mawrob/Tesla-model-S-front-camera/pcb.jpg

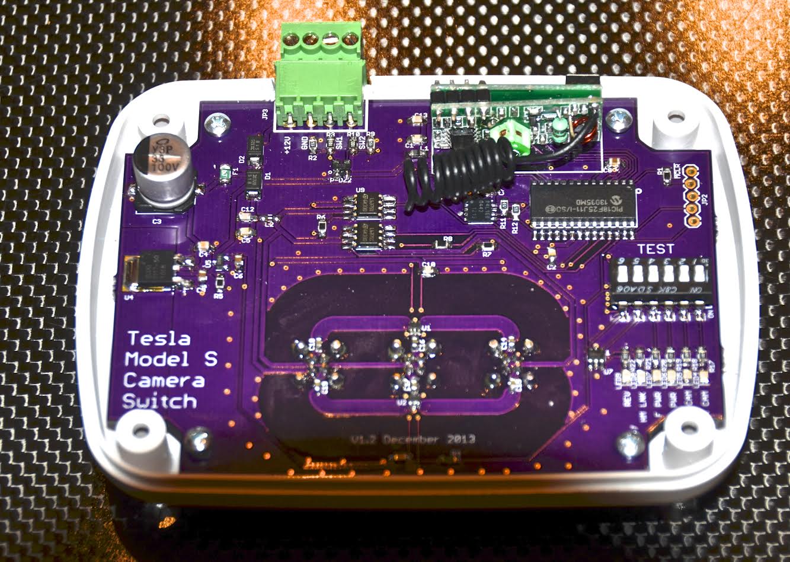
pcb.jpg
