mawrob/Tesla-model-S-front-camera/README.md

# Tesla-model-S-front-camera
Module to enable switching between a newly added front camera and the standard rear camera.

These are the camera switch manufacturing files for a Tesla Model S.

See: http://www.teslarati.com/tesla-model-s-front-camera-touchscreen-kit/
