mawrob/Tesla-model-S-front-camera/RT079 modification.pdf

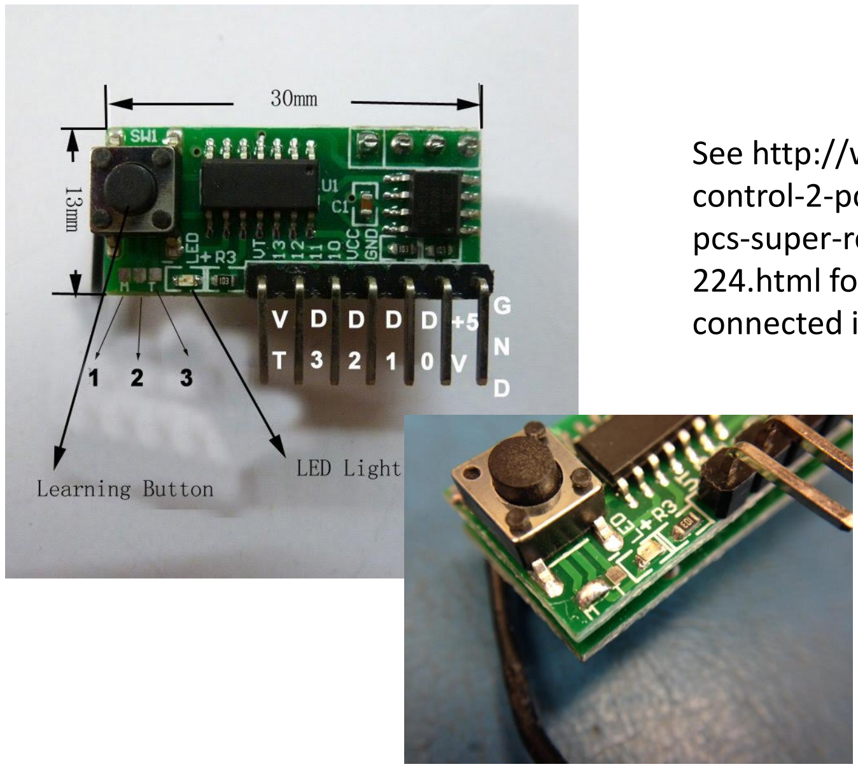
[picture p2: figure]

See http://www.canton-electronics.com/wirelesscontrol-2-pcs-4-way-ev1527-encoder-remotes-1-pcs-super-regenerative-receivers-433mhz-p-224.html for details. Pads 1 and 2 need to be connected in the "momentary" mode.
