mawrob/Tesla-model-S-front-camera/BOM.xlsx

VALUE | DESCRIPTION | MFR | MFPN | VEND | VPN | QTY | EACH | COST | REF | NOTES
33uF | CAP ALUM 33UF 100V 20% SMD | Nichicon | UUX2A330MNL1GS | Digi-Key | 493-6281-1-ND | 1 | 0.33428 | 0.33428 | C3 | Alternative Panasonic EEE-HD1J330P
0.1uF | CAP CER 0.1UF 50V 10% X7R 0805 | AVX CORPORATION (VA) | 08055C104KAT2A | Digi-Key | 478-1395-1-ND | 5 | 0.019 | 0.095 | C10,C7,C5,C2,C1
0.01uF | CAP CER 10000PF 50V 10% X7R 0805 | Kemet | C0805C103K5RACTU | Digi-Key | 399-1158-1-ND | 3 | 0.0154 | 0.0462 | C13,C12,C11
10uF | CAP CER 10UF 10V Y5V 0805 | Yageo | CC0805ZKY5V6BB106 | Digi-Key | 311-1355-1-ND | 3 | 0.0522 | 0.1566 | C9,C8,C6
1uF | CAP CER 1UF 50V 10% X5R 0603 | Taiyo Yuden | UMK107BJ105KA-T | Digi-Key | 587-2400-1-ND | 6 | 0.0523 | 0.3138 | C19,C18,C17,C16,C15,C14
1uF | CAP CER 1UF 50V Y5V 0805 | Samsung Electro-Mechanics America, Inc | CL21B105KBFNNNE | Digi-Key | 1276-1029-1-ND | 1 | 0.03 | 0.03 | C4
FAKRA-HSB | Fakra Jack PCB mount Straight 4 Contact pin Connector for Blue GPS telematics or navigation |  |  | RFSupplier.com | F03-SJPT4-C | 3 | 2.73 | 8.19 | SCREEN,REAR,FRONT
220@100MHz | FERRITE CHIP 220 OHM 1500MA 0805 | Samsung Electro-Mechanics America, Inc | CIC21J221NE | Digi-Key | 1276-6372-1-ND | 2 | 0.0223 | 0.0446 | L2,L1
SN74LVC2G34 | IC BUFFER DUAL NON-INV SOT23-6 | Texas Instruments | SN74LVC2G34DBVR | Digi-Key | 296-13496-1-ND | 1 | 0.37 | 0.37 | U7 | Do not populate
L6375S | IC DRIVER HI SIDE 0.5A IPS SOIC8 | STMicroelectronics | L6375STR | Digi-Key | 497-6865-1-ND | 2 | 2.9688 | 5.9376 | U9,U8
FM24C16 | IC FRAM 16KBIT 1MHZ 8TDFN | Cypress Semiconductor Corp | FM24CL16B-DG | Digi-Key | FM24CL16B-DGRA-ND | 1 | 1.44 | 1.44 | U6 | New 4x4.5mm footprint
PIC18F25J11 | IC MCU 8BIT 32KB FLASH 28SOIC | Microchip Technology | PIC18F25J11-I/SO | DigiKey | PIC18F25J11-I/SO-ND | 1 | 2.08 | 2.08 | U3
MCP1700 | IC REG LDO 3V 0.25A SOT23-3 | Microchip Technology | MCP1700T-3002E/TT | Digi-Key | MCP1700T-3002E/TTCT-ND | 1 | 0.28 | 0.28 | U5
ZLDO1117K50TC-5.0V | IC REG LDO 5V 1A TO252-3 | Diodes Incorporated | ZLDO1117K50TC | Digi-Key | ZLDO1117K50DICT-ND | 1 | 0.4017 | 0.4017 | U4
PE4283 | IC RF SWITCH SPDT 50 OHM SC70-6 | Peregrine Semiconductor | 4283-52 | Digi-Key | 1046-1030-1-ND | 2 | 0.7127 | 1.4254 | U2,U1
Green | LED 2X1.2MM 570NM GN WTR CLR SMD | Kingbright Corp | APT2012CGCK | Digi-Key | 754-1127-1-ND | 6 | 0.11 | 0.66 | LED8,LED7,LED6,LED5,LED4,LED2 | Do not populate
Green | LED 2X1.2MM 570NM GN WTR CLR SMD | Kingbright Corp | APT2012CGCK | Digi-Key | 754-1127-1-ND | 7 | 0.1073 | 0.7511 | LED9,LED8,LED7,LED6,LED5,LED4,LED2 | Do not populate
Yellow | LED 2X1.2MM 588NM YW WTR CLR SMD | Kingbright Corp | APT2012YC | Digi-Key | 754-1135-1-ND | 1 | 0.08 | 0.08 | LED3 | Do not populate
Red | LED 2X1.2MM 640NM RD WTR CLR SMD | Kingbright Corp | APT2012SRCPRV | Digi-Key | 754-1132-1-ND | 1 | 0.1 | 0.1 | LED1 | Do not populate
PTCSMD | PTC RESTTBLE 0.35A 16V CHIP 1206 | Bel Fuse Inc | 0ZCA0035FF2G | Digi-Key | 507-1479-1-ND | 1 | 1.28 | 1.28 | F1
 | RES 1.0K OHM 1/8W 5% 0805 SMD | Yageo | RC0805JR-071KL | Digi-Key | 311-1.0KARCT-ND | 2 | 0.0077 | 0.0154 | R8,R4
10k | RES 10K OHM 1/8W 5% 0805 SMD | Yageo | RC0805JR-0710KL | Digi-Key | 311-10KARCT-ND | 2 | 0.007 | 0.014 | R10,R3
180 | RES 180 OHM 1/8W 5% 0805 SMD | Yageo | RC0805JR-07180RL | Digi-Key | 311-180ARCT-ND | 3 | 0.0077 | 0.0231 | R7,R6,R5 | Do not populate,Do not populate,Do not populate
220 | RES 220 OHM 1/8W 5% 0805 SMD | Panasonic Electronic Components | ERJ-6GEYJ221V | Digi-Key | P220ACT-ND | 4 | 0.0149 | 0.0596 | R20,R19,R18,R17 | Do not populate,Do not populate,Do not populate,Do not populate
3k3 | RES 3.3K OHM 1/8W 5% 0805 SMD | Yageo | RC0805JR-073K3L | Digi-Key | 311-3.3KARCT-ND | 4 | 0.0077 | 0.0308 | R12,R11,R9,R2
330 | RES 330 OHM 1/8W 5% 0805 | Stackpole Electronics Inc | RMCF0805JT330R | Digi-Key | RMCF0805JT330RCT-ND | 2 | 0.0071 | 0.0142 | R22,R21 | Do not populate
4k7 | RES 4.70K OHM 1/8W 1% 0805 SMD | Yageo | RC0805FR-074K7L | Digi-Key | 311-4.70KCRCT-ND | 1 | 0.006 | 0.006 | R1
SWITCHDIP6-SMD | SWITCH DIP TOP SLIDE 6POS 24V | C&K Components | SDA06H1SBD | DigiKey | CKN6080-ND | 1 | 1.63 | 1.63 | DIP6 | Do not populate
 | TERM BLOCK HEADER 4POS R/A 3.5MM | TE Connectivity | 284512-4 | Digi-Key | A98398-ND | 1 | 2.7602 | 2.7602 | JP3 | Mates with A98375-ND $1.8952
TVSDIODE | TVS AVAL DIODE ARRAY 3 CH SOT143 | Littelfuse Inc | SP0503BAHTG | Digi-Key | F2715CT-ND | 1 | 0.51548 | 0.51548 | P-DZ2
CJ005 | Wireless Control 2 PCS 4 Way EV1527 Encoder Remotes & 1 PCS Super Regenerative Receivers 433MHZ | Canton Electronics | RT079 | Canton Electronics | RT079 | 1 | 19.15 | 19.15 | RX1 | Plus two remotes: http://www.canton-electronics.com/wireless-control-2-pcs-4-way-ev1527-encoder-remotes-1-pcs-super-regenerative-receivers-433mhz-p-224.html
NF |  |  |  |  |  | 0 | 0 | 0 | JP2 | Do not populate
 |  | Diodes, Inc | S1B-13-F | Digi-Key | S1B-FDITR-ND | 2 | 0.2184 | 0.4368 | D2,D1
