mawrob/Tesla-model-S-front-camera/Tesla Camera PCB version 1 schematic.pdf

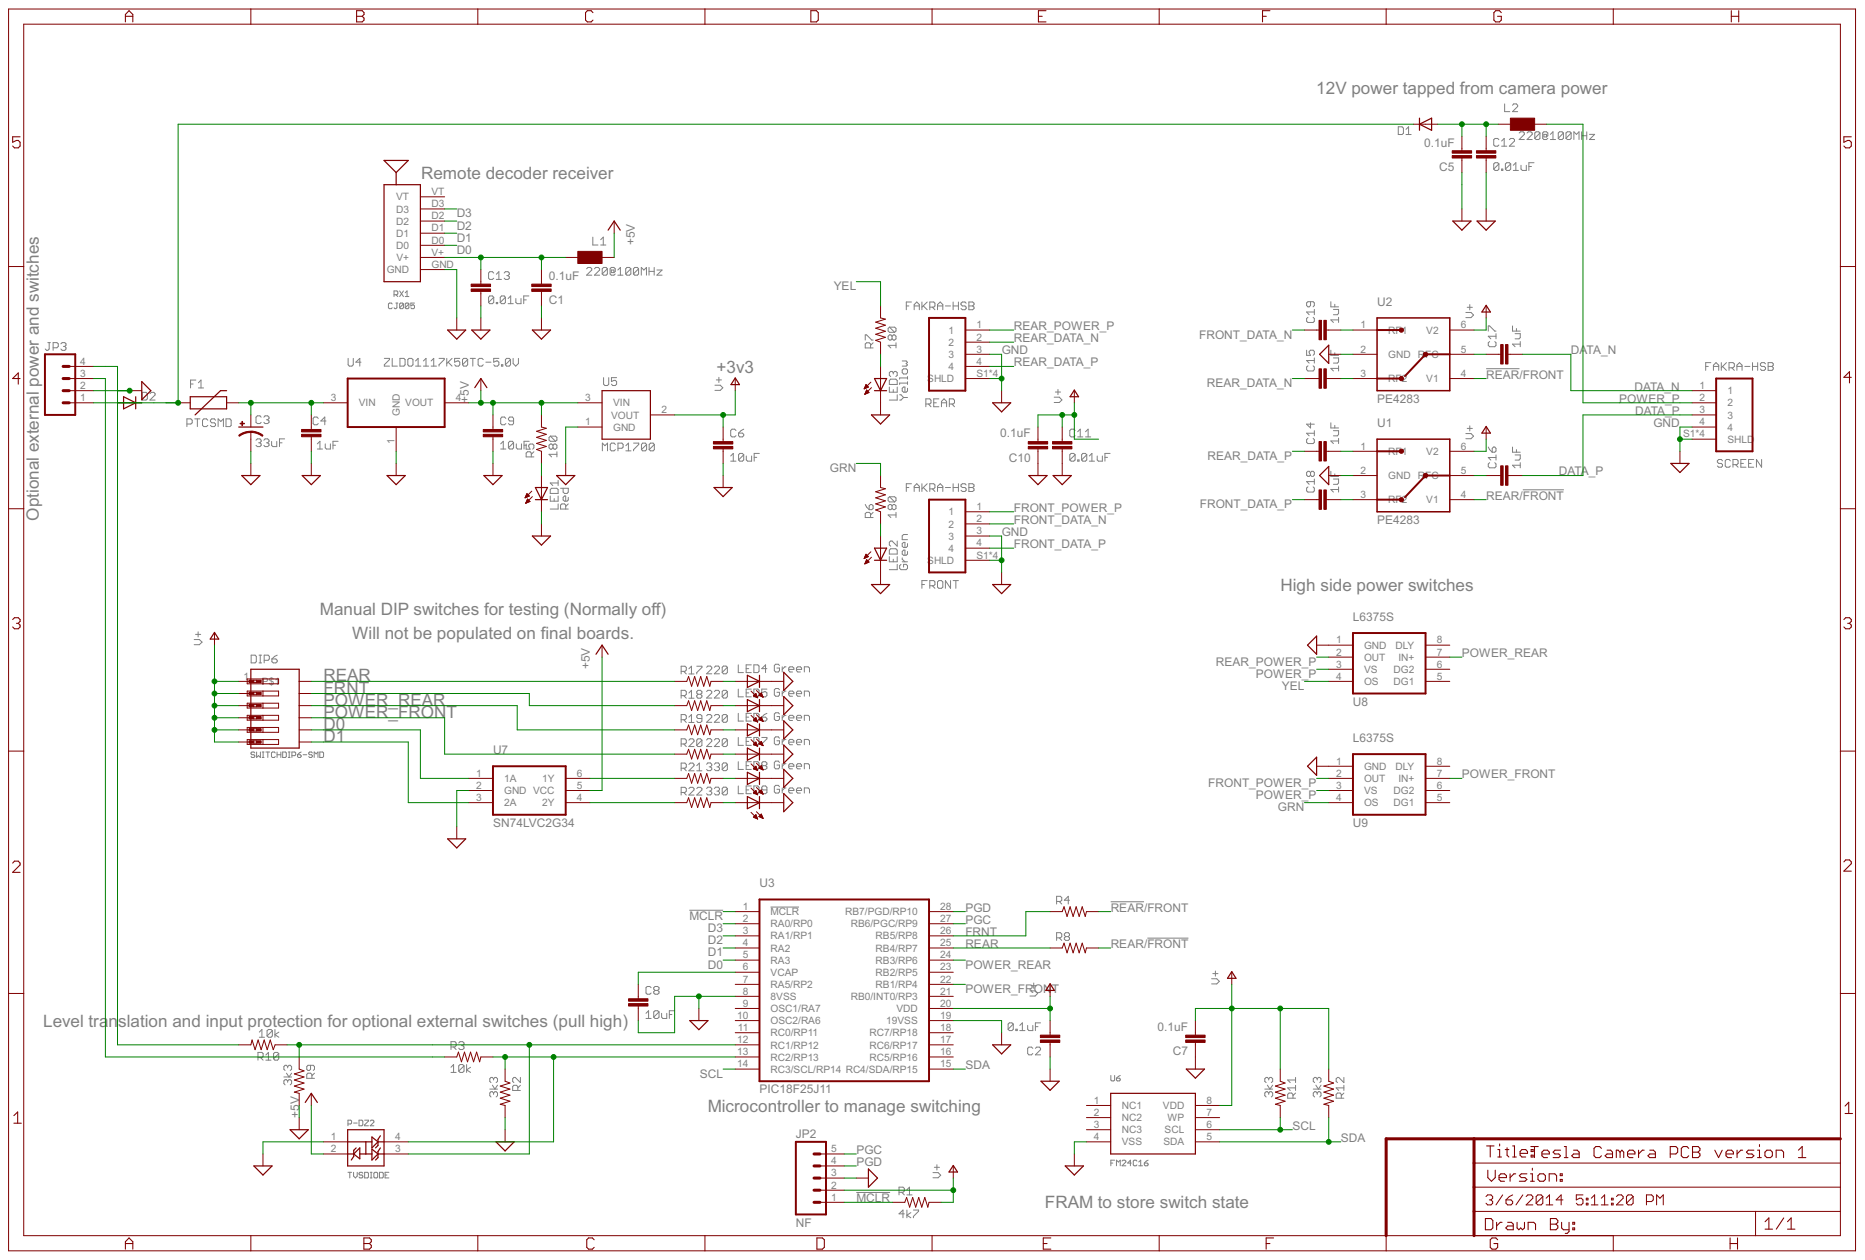
[picture p3: page 1]

12V power tapped from camera power

Optional external power and switches

High side power switches

Manual DIP switches for testing (Normally off)
Will not be populated on final boards.

Level translation and input protection for optional external switches (pull high)

FRAM to store switch state Microcontroller to manage switching
