mawrob/Tesla-model-S-front-camera/Tesla Camera PCB version 1.brd

## EAGLE design Tesla Camera PCB version 1.brd (2017-01-11)

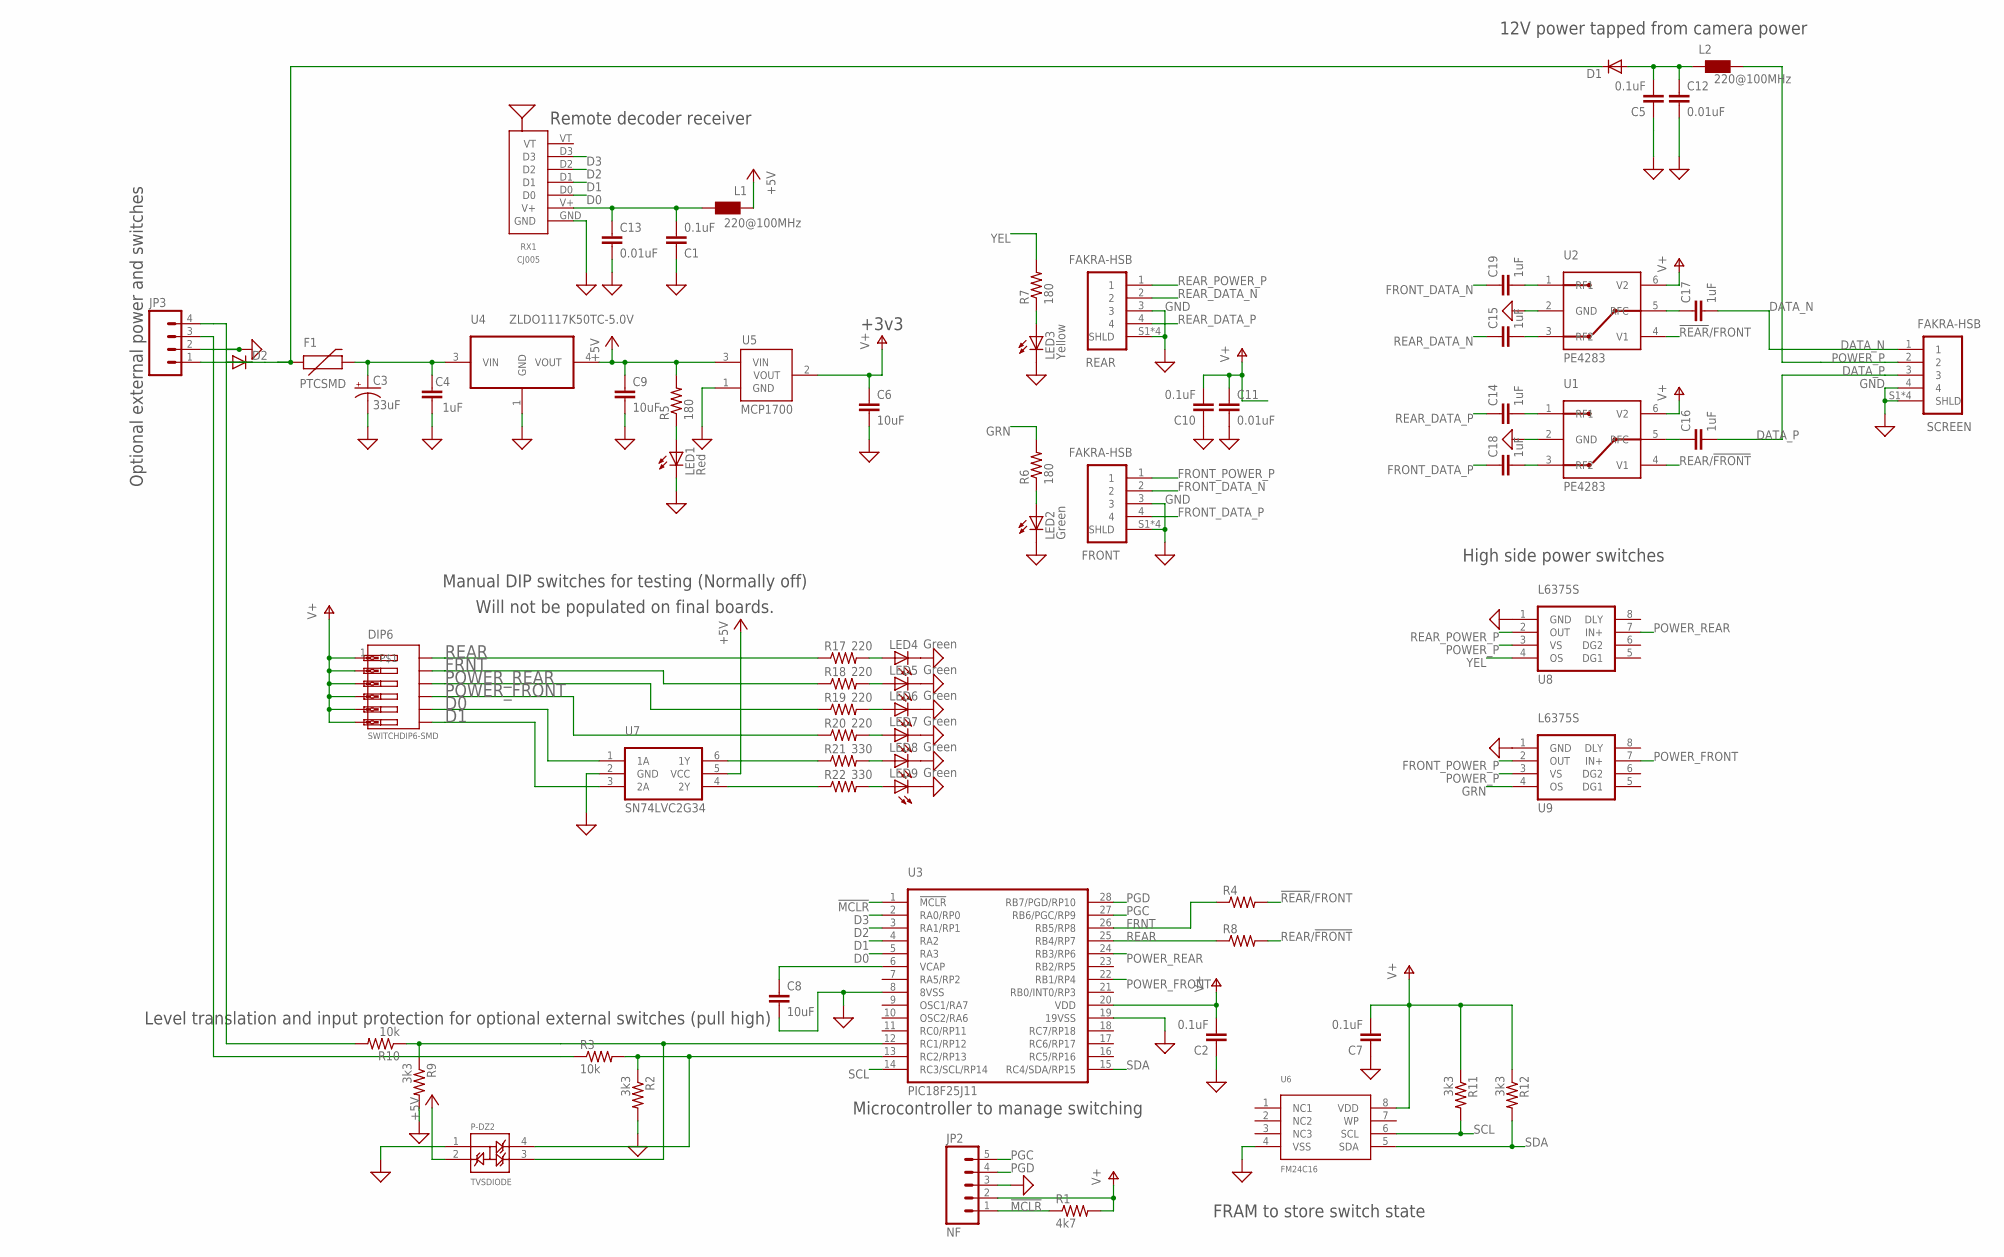
[picture p4: schematic Tesla Camera PCB version 1.sch]

Parts:
C1, C2, C5, C7, C10: 0.1uF; 0805
C3: 33uF; CAPVTYPE
C4: 1uF; 0805
C6, C8, C9: 10uF; 0805
C11, C12, C13: 0.01uF; 0805
C14, C15, C16, C17, C18, C19: 1uF; 0603-CAP
D1, D2: DIODE-DO-214AC; DO-214AC
DIP6: SWITCHDIP6-SMD; SWITCHDIP6
F1: PTCSMD; PTC-1206
FRONT: FAKRA-HSB; FAKRA
JP2: NF; 1X05_LOCK
JP3: M04-LOCK; 1X04_TERM_3.5MM
L1, L2: 220@100MHz; 0805
LED1: Red; 0805_LED
LED2, LED4, LED5, LED6, LED7, LED8, LED9: Green; 0805_LED
LED3: Yellow; 0805_LED
P-DZ2: TVSDIODE; SOT143
R1: 4k7; 0805
R2, R9, R11, R12: 3k3; 0805
R3, R10: 10k; 0805
R4, R8: RESISTOR; 0805
R5, R6, R7: 180; 0805
R17, R18, R19, R20: 220; 0805
R21, R22: 330; 0805
REAR: FAKRA-HSB; FAKRA
RX1: CJ005
SCREEN: FAKRA-HSB; FAKRA
U1, U2: PE4283; SC70-6
U3: PIC18F25J11; SOIC-28-WIDE
U4: ZLDO1117K50TC-5.0V; TO252
U5: MCP1700; SOT23-3
U6: FM24C16; TDFN-8-FRAM
U7: SN74LVC2G34; SOT23-6
U8, U9: L6375S; SO08-EIAJ

Connections:
!MCLR: JP2.1, R1.1, U3.1 (!MCLR)
!REAR!/FRONT: R4.2, U2.4 (V1)
+5V: C9.1, L1.1, P-DZ2.2, R5.2, U4.4 (VOUT), U5.3 (VIN), U7.5 (VCC)
D0: DIP6.8, RX1.D0, U3.5 (RA3), U7.1 (1A)
D1: DIP6.7, RX1.D1, U3.4 (RA2), U7.3 (2A)
D2: RX1.D2, U3.3 (RA1/RP1)
D3: RX1.D3, U3.2 (RA0/RP0)
DATA_N: C17.2, SCREEN.1
DATA_P: C16.2, SCREEN.3
FRNT: DIP6.11, R4.1, R18.1, U3.26 (RB5/RP8)
FRONT_DATA_N: C19.1, FRONT.2
FRONT_DATA_P: C18.1, FRONT.4
FRONT_POWER_P: FRONT.1, U9.2 (OUT)
GND: C1.1, C2.1, C3.-, C4.2, C5.1, C6.2, C7.1, C8.2, C9.2, C10.1, C11.2, C12.2, C13.2, FRONT.3, FRONT.S1 (SHLD), FRONT.S2 (SHLD), FRONT.S3 (SHLD), FRONT.S4 (SHLD), JP2.3, JP3.2, LED1.C, LED2.C, LED3.C, LED4.C, LED5.C, LED6.C, LED7.C, LED8.C, LED9.C, P-DZ2.1, R2.2, R9.2, REAR.3, REAR.S1 (SHLD), REAR.S2 (SHLD), REAR.S3 (SHLD), REAR.S4 (SHLD), RX1.GND, SCREEN.4, SCREEN.S1 (SHLD), SCREEN.S2 (SHLD), SCREEN.S3 (SHLD), SCREEN.S4 (SHLD), U1.2 (GND), U2.2 (GND), U3.8 (8VSS), U3.19 (19VSS), U4.1 (GND), U5.1 (GND), U6.4 (VSS), U7.2 (GND), U8.1 (GND), U9.1 (GND)
GRN: R6.2, U9.4 (OS)
unnamed: C5.2, C12.1, D1.A, L2.1
unnamed: P-DZ2.3, R9.1, R10.1, U3.12 (RC1/RP12)
unnamed: LED2.A, R6.1
unnamed: JP3.3, R3.1
unnamed: JP3.4, R10.2
unnamed: C8.1, U3.6 (VCAP)
unnamed: C19.2, U2.1 (RF1)
unnamed: C15.2, U2.3 (RF2)
unnamed: D1.C, D2.C, F1.1
unnamed: C17.1, U2.5 (RFC)
unnamed: D2.A, JP3.1
unnamed: C16.1, U1.5 (RFC)
unnamed: LED3.A, R7.1
unnamed: C3.+, C4.1, F1.2, U4.3 (VIN)
unnamed: LED1.A, R5.1
unnamed: C18.2, U1.3 (RF2)
unnamed: C14.2, U1.1 (RF1)
unnamed: LED4.A, R17.2
unnamed: LED5.A, R18.2
unnamed: LED6.A, R19.2
unnamed: LED7.A, R20.2
unnamed: LED8.A, R21.2
unnamed: LED9.A, R22.2
unnamed: R21.1, U7.6 (1Y)
unnamed: R22.1, U7.4 (2Y)
unnamed: P-DZ2.4, R2.1, R3.2, U3.13 (RC2/RP13)
PGC: JP2.5, U3.27 (RB6/PGC/RP9)
PGD: JP2.4, U3.28 (RB7/PGD/RP10)
POWER_FRONT: DIP6.9, R20.1, U3.22 (RB1/RP4), U9.7 (IN+)
POWER_P: L2.2, SCREEN.2, U8.3 (VS), U9.3 (VS)
POWER_REAR: DIP6.10, R19.1, U3.24 (RB3/RP6), U8.7 (IN+)
REAR: DIP6.12, R8.1, R17.1, U3.25 (RB4/RP7)
REAR/!FRONT: R8.2, U1.4 (V1)
REAR_DATA_N: C15.1, REAR.2
REAR_DATA_P: C14.1, REAR.4
REAR_POWER_P: REAR.1, U8.2 (OUT)
SCL: R11.2, U3.14 (RC3/SCL/RP14), U6.6 (SCL)
SDA: R12.2, U3.15 (RC4/SDA/RP15), U6.5 (SDA)
V+: C2.2, C6.1, C7.2, C10.2, C11.1, DIP6.1, DIP6.2, DIP6.3, DIP6.4, DIP6.5, DIP6.6, JP2.2, R1.2, R11.1, R12.1, U1.6 (V2), U2.6 (V2), U3.20 (VDD), U5.2 (VOUT), U6.8 (VDD)
V+1: C1.2, C13.1, L1.2, RX1.V+
YEL: R7.2, U8.4 (OS)

Notes on the sheet:
High side power switches
Remote decoder receiver
Optional external power and switches
FRAM to store switch state
Microcontroller to manage switching
12V power tapped from camera power
+3v3
Level translation and input protection for optional external switches (pull high)
Manual DIP switches for testing (Normally off)
Will not be populated on final boards.

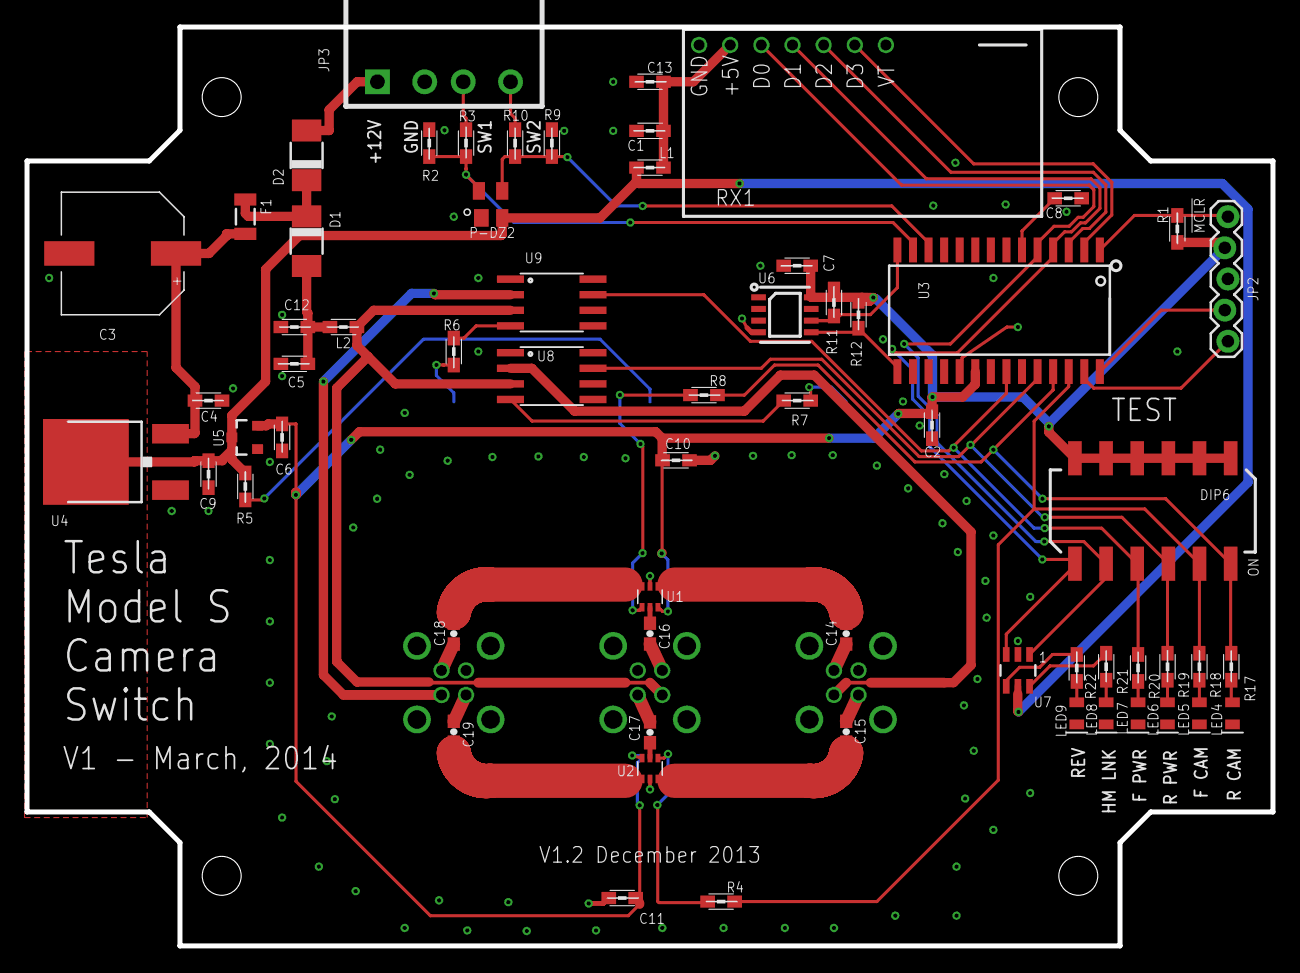
[picture p5: board Tesla Camera PCB version 1.brd from above]

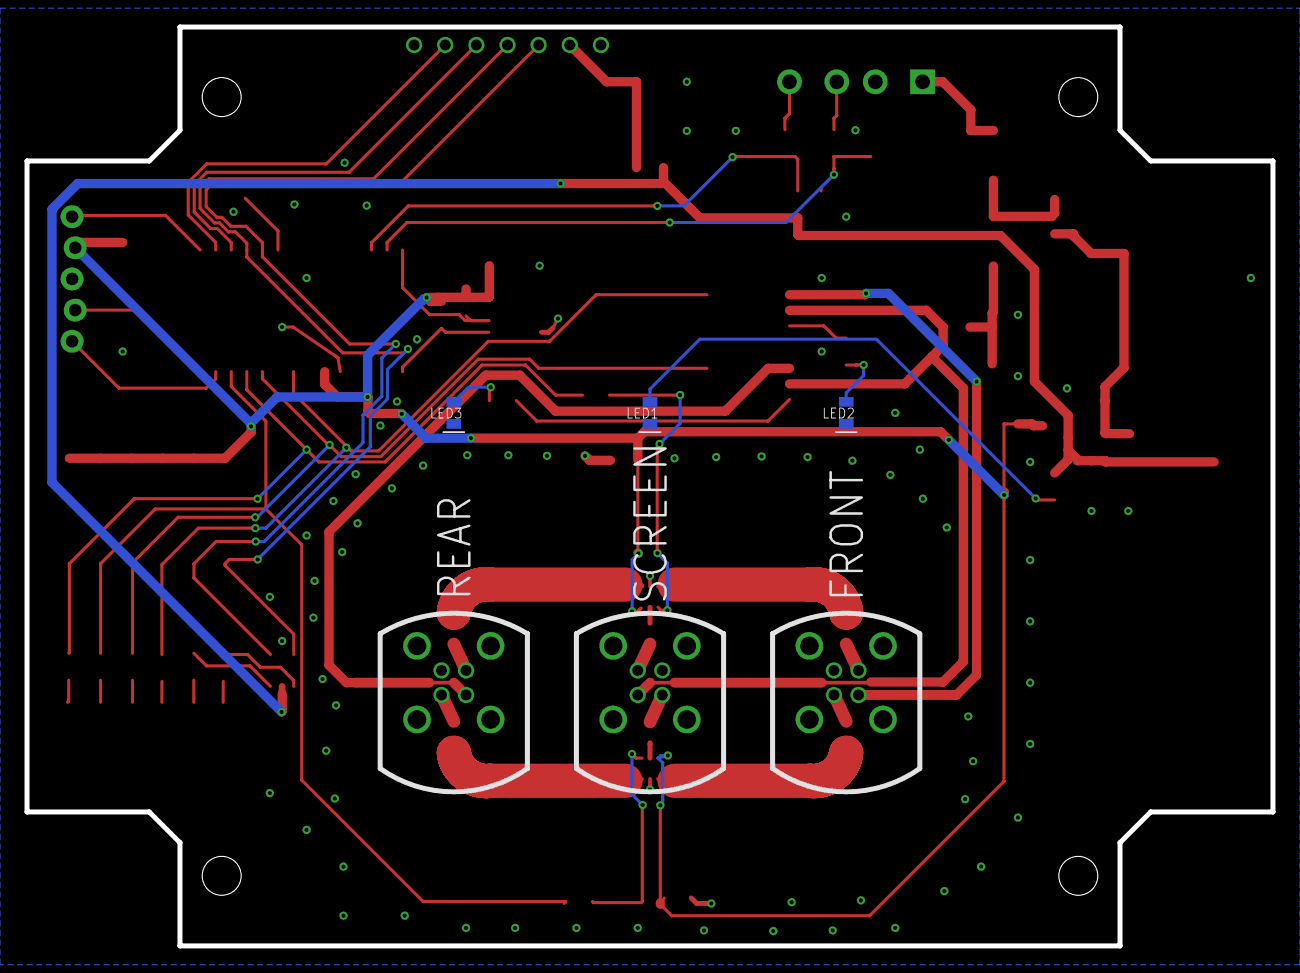
[picture p6: board Tesla Camera PCB version 1.brd from below]

Board: 2 copper layers, 101.6 x 74.9 mm, 68 parts (6 on the bottom side), 56 nets.
