mawrob/Tesla-model-S-front-camera/Recommended manufacturer contact details.txt

Neil Scanlon
President
Worthington Assembly, Inc.
ISO  9001:2008 certified
14 Industrial Drive East
South Deerfield, MA 01373
www.worthingtonassembly.com
 
Main Phone:  1.413.397.8260
Direct Line:     1.413.397.8270
Fax:                  1.413.397.8293
Mobile:           1.413.262.7227
