mawrob/Tesla-model-S-front-camera/Tsla version 1 manufacturing.pdf

Tesla Camera PCB version 1_Border.BOR, Scale( 2.2X ), Ruler( 1=1.000 inch), 03/06/14@17:16:07

Border

0.0

1.0

2.0

3.0

0.0 | 1.0 | 2.0 | 3.0 | 4.0

Tesla Camera PCB version 1_Bottom_Copper.GBL, Scale( 2.2X ), Ruler( 1=1.000 inch), 03/06/14@17:16:07

Bottom

0.0

1.0

2.0

3.0

0.0 | 1.0 | 2.0 | 3.0 | 4.0

Tesla Camera PCB version 1_Bottom_Silk.GBO, Scale( 2.2X ), Ruler( 1=1.000 inch), 03/06/14@17:16:07

Silk Bottom

0.0

1.0

2.0

3.0

0.0 | 1.0 | 2.0 | 3.0 | 4.0

Tesla Camera PCB version 1_Bottom_Soldermask.GBS, Scale( 2.2X ), Ruler( 1=1.000 inch), 03/06/14@17:16:08

Mask Bottom

0.0

1.0

2.0

3.0

0.0 | 1.0 | 2.0 | 3.0 | 4.0

Tesla Camera PCB version 1_Top_Copper.GTL, Scale( 2.2X ), Ruler( 1=1.000 inch), 03/06/14@17:16:08

Top

0.0

1.0

2.0

3.0

0.0 | 1.0 | 2.0 | 3.0 | 4.0

Tesla Camera PCB version 1_Top_Paste.GTP, Scale( 2.2X ), Ruler( 1=1.000 inch), 03/06/14@17:16:08

Paste Top

0.0

1.0

2.0

3.0

0.0 | 1.0 | 2.0 | 3.0 | 4.0

Tesla Camera PCB version 1_Top_Silk.GTO, Scale( 2.2X ), Ruler( 1=1.000 inch), 03/06/14@17:16:09

Silk Top

0.0

1.0

2.0

3.0

0.0 | 1.0 | 2.0 | 3.0 | 4.0

Tesla Camera PCB version 1_Top_Soldermask.GTS, Scale( 2.2X ), Ruler( 1=1.000 inch), 03/06/14@17:16:09

Mask Top

0.0

1.0

2.0

3.0

0.0 | 1.0 | 2.0 | 3.0 | 4.0

Tesla Camera PCB version 1_Drill.TXT, Scale( 2.2X ), Ruler( 1=1.000 inch), 03/06/14@17:16:09

Drill ThruHole

0.0

1.0

2.0

3.0

0.0 | 1.0 | 2.0 | 3.0 | 4.0
